soranatsu/Low-Power-MCA/firmware/STM32G474_AD7980_FinalAdaptive_ver2.6.2/DOCUMENT_ANALYSIS.md

# 文档结论与工程落实矩阵

| 资料 | 与本工程有关的结论 | 工程落实 |
|---|---|---|
| 赛题讲解、基础信息 | 需要外部输入0–1 V能谱、至少1024道；覆盖500 mV/1 kHz、100–900 mV每50 mV、100 mV/1–100 kHz测试 | 原理图BAMP约2倍增益，故把ADC端0–2 V映射为4096道，等价于外部输入0–1 V；提供baseline/amplitude/frequency profile、CSV/TXT、直方图和计数统计 |
| STM32G474VET6 开发板原理图/数据手册 | PA0/1/4/5/6 可用于本板关键链；PA11/PA12 为原生 USB；LCD/FPC 与 PA0/1/5/6 等网络复用 | USB CDC 使用 PA11/PA12；LCD/FPC 完全禁用；关键引脚和危险接地脚均在 `.ioc` 中锁定 |
| AD7980 ARM/BRM 数据手册 | 三线 CS busy 模式要求 SDI 接 VIO；CNV 高启动转换且必须在完成前回低；busy 为 SDO 下降；前 16 个 SCK 下降沿给出 D15..D0；可用第 17 个下降沿释放 SDO 高阻 | CNV 不由 MCU 驱动；PA0 只收 busy；PA5 产生 16 个取数边沿和 1 个释放边沿；PA6 只输入；ARM/BRM 共用同一固件 |
| SN74LVC1G123 | `/CLR=1、A=0` 时 B 上升沿触发；`/CLR=1、B=1` 时 A 下降沿触发 | 第一片由比较器上升沿产生约 500 ns 延时窗；其 Q 下降沿触发第二片产生约 140 ns CNV |
| LTC6993-3 | `-3` 为下降沿触发且不可重触发；DIV 高时为低有效输出；脉宽由 RSET 决定 | CNV 下降沿产生约 2.54 us 的低电平 `Trig_SHDN`，固件不介入该关断窗 |
| ADG721 | 数字输入高使对应开关导通，3.3 V 逻辑兼容；开关时间远短于 1 us | PA1 在 ADC 数据及 SDO 释放完成后输出 1 us 高脉冲，使接地开关导通并放掉峰保持电容 |
| LMV7239-Q1 | 高速比较器输出建立触发边沿 | 比较器完全属于模拟触发链；MCU 只接收最终 ADC busy，不采比较器输出 |
| ADR431 | 2.5 V 精密参考，输出需按手册去耦和稳定性要求布局 | 固件用 2500 mV 作为 AD7980 满量程换算基准；实际标定可根据实测参考值调整常量 |
| ADA4841、OPA320、OPA615、OPA810、THS4631 | 属于缓冲、峰保持或备选高速模拟器件；带宽、压摆率、输入范围和稳定性影响模拟误差，但没有 MCU 配置接口 | 固件不对这些器件作控制；上板验收应以 PH_out 稳定时间、过冲、保持下垂和噪声实测为准 |
| LM66100 | USB/板上 5 V 电源路径的理想二极管、防倒灌器件 | 无软件接口；上电前必须确认器件焊接及供电方向，USB 仅承担 CDC 通信 |

## 关键计算

- AD7980 参考为 2.5 V：`voltage_mV = raw * 2500 / 65535`。
- 外部0–1 V经约2倍BAMP后对应ADC端0–2 V；2 V对应约52428码。0..52427映射到0..4095道，达到或超过52428的事件计入 `range_overflows` 并钳位到第4095道。
- 比较器阈值分压：`Vthreshold = VDAC / 10.1`；命令 `threshold 75` 会令 PA4 约输出 757.5 mV。
- 150 MHz Cortex-M4 单周期约 6.67 ns。Release 反汇编确认每次 PA5 翻转后仍保留四个 NOP；满足 AD7980 在 VIO=3.3 V 下的 tDSDO(max)=11 ns、tDIS(max)=20 ns 和 SCK 高/低时间要求。

## 边界说明

工程已通过配置加载、源码编译、链接和反汇编时序检查。数据手册分析可以证明数字接口方案一致，但不能替代实板对模拟稳定性、噪声、供电完整性和连接器镜像方向的测量；首次上电必须执行 `TEST_PROCEDURE.md` 的限流和示波器检查。
