soranatsu/Low-Power-MCA/firmware/STM32G474_AD7980_FinalAdaptive_ver2.6.2/PC_Monitor/核电子学多道分析系统_完整项目文档.docx

基于 FPGA 指数脉冲信号发生器与 STM32G474 + AD7980 的核电子学多道分析系统

从可控激励、模拟峰保持到多道能谱与 USB 上位机的端到端项目文档

完整工程档案 · 可运行验证版 · 2026年8月

文档状态：基于当前工作区、工程说明、设计文件和实板测试反馈整理。代表性数据按测试条件标注，不将单次截图结果等同于系统的普遍极限。

# 摘要与项目状态

本项目面向核电子学赛道的多道能谱测量需求，搭建了一条可重复激励、可观测时序、可配置阈值、可连续采集的端到端链路。前端使用 A7-LITE/ADA-107 上的 FPGA 产生可调双指数脉冲，模拟板完成缓冲、峰保持、触发及 AD7980 采样，STM32G474 负责 busy 事件响应和 16 位串行读数，PC 端通过 USB CDC 完成能谱显示、统计、校准、导出和状态监视。

当前工程的主线版本为 STM32G474_AD7980_FinalAdaptive。4096 道模式用于高计数率稳定运行；8192、16384 和 65536 道模式保留原始码的诊断和校准价值。ARM 与 BRM 两种 AD7980 器件采用同一数字接口和同一软件协议。

项目项 | 当前状态 | 工程含义
安全引脚约束 | 已固化 | PA2/PA3/PC4/PC5/PF2 模拟高阻；LCD/FPC/USART2 不启用
核心采集链路 | 已实板验证 | PA0/PA1/PA4/PA5/PA6 + 外部 CNV
持续能谱 | 已实板验证 | USB CDC、批量数据、CRC/序号、恢复统计
低幅平台问题 | 已通过硬件改版改善 | 保持电容由 200 pF 改为 1 nF 后低幅线性明显改善
高计数率策略 | 已定义 | 高计数率优先本地直方图；原始 16 位流用于校准/诊断
性能边界 | 仍需条件化描述 | 受模拟噪声、FPGA 激励、USB 调度和测试配置影响

# 1 项目起因与指标

项目起因为核电子学赛道对脉冲幅度测量、能谱显示和分辨率评价的综合要求。单独验证 ADC 读数不足以证明系统可用，还必须把输入端阻抗、峰保持建立、触发延迟、转换完成判定、数据传输和上位机统计放在同一条可复现实验链中。

需求维度 | 目标/约束 | 验证口径
输入激励 | 500 mV / 1 kHz；100–900 mV、50 mV 步进；100 mV / 1–100 kHz | 以板端实际幅度和频率为准，不只看发生器设定值
采样器件 | AD7980 ARM/BRM，2.5 V 参考，16 位串行输出 | ARM/BRM 的数字时序和软件接口相同
多道输出 | 至少 1024 道；工程保留 4096/8192/16384/65536 选项 | 高道址模式不等于 ADC 有效位数提升
分辨率 | 比赛目标为 FWHM < 1% 的代表性工况 | 必须注明输入幅度、匹配方式、频率和统计时间
通信 | USB CDC 实时输出、TXT/CSV 记录 | 采用安全命令白名单，不控制 CNV 和危险 GPIO

工程边界：FPGA 的 10 位 DAC 负责产生激励，AD7980 的 16 位输出负责采样量化。两者位数不同是系统分辨率链的一部分，但不能把 16 位码流直接解释为 16 位 ENOB。

# 2 总体架构

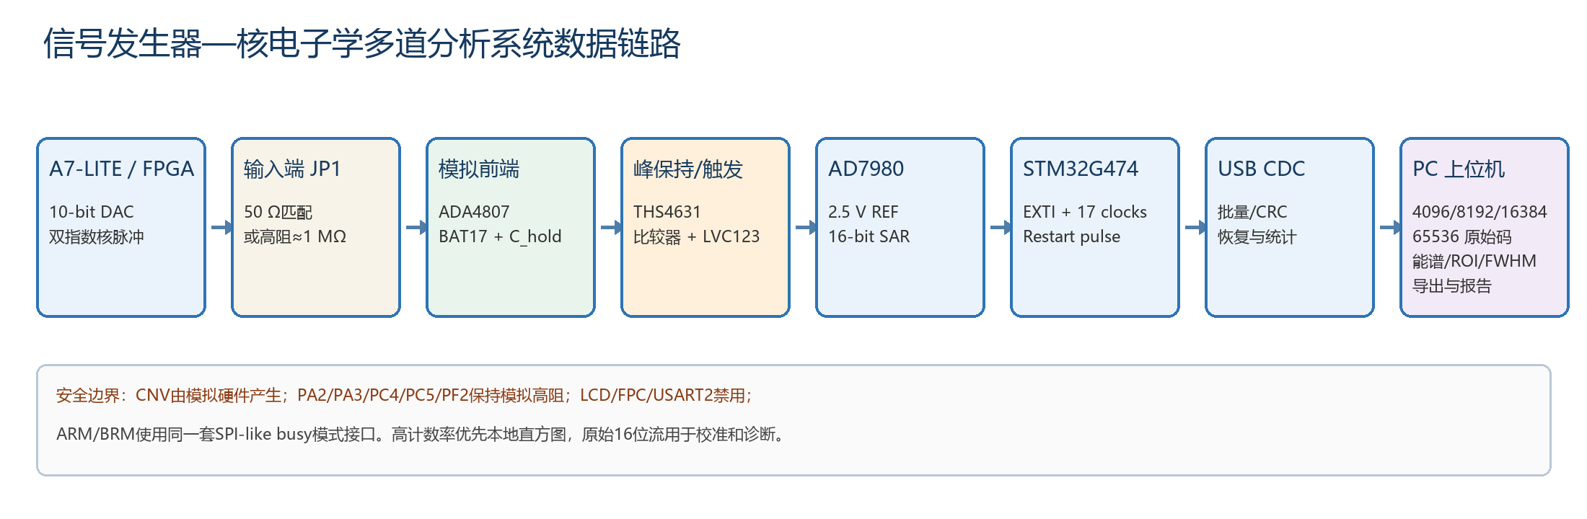
[picture p14: figure]

系统以外部模拟 CNV 为边界：CNV 由模拟板上的比较器、SN74LVC1G123 和 LTC6993-3 产生，STM32 不产生 CNV，也不主动驱动 CNV 线。MCU 只在 AD7980 转换完成后读取 SDO，并在读数结束后输出 PH_RESTART 释放峰保持电容。

层级 | 模块 | 职责
激励层 | A7-LITE + ADA-107 + FPGA | 生成可调双指数脉冲，提供可控幅度/频率和 JTAG 调试入口
模拟层 | 输入匹配、ADA4807、BAT17、THS4631 | 缓冲、峰值捕获、保持和 ADC 驱动
时序层 | 比较器、LVC123、LTC6993-3、ADG721 | 触发、延时、CNV、ADA4807 关断和保持电荷释放
采集层 | AD7980 + STM32G474 | busy 事件、16 位数据、异常统计、USB CDC
分析层 | PC_Monitor | 直方图、ROI、峰值/FWHM、cps、校准和导出

# 3 FPGA 信号发生器

当前采用 A7EXP 工程作为可调激励主线。设计使用 50 MHz 板载时钟，经 MMCM 生成 125 MHz 采样时钟；脉冲形状采用双指数模型，DAC 数据在下降沿更新，使用 ODDR 转发 DAC 时钟。该结构把数字数据更新和 DAC 采样边沿分开，便于示波器观察和后续时序约束。

功能 | 实现 | 测试/使用说明
默认点 | 500 mV、1 kHz | 用于上电后的快速基线检查
幅度调节 | 100–900 mV，步进 50 mV | K2/K3 增减，LED2 表示幅度模式
频率调节 | 1–100 kHz，步进 1 kHz | K2/K3 增减，LED1 表示频率模式
模式键 | K1 切换幅度/频率 | 按键消抖在 RTL 中实现
接口 | ADA-107 DAC 与 A7-LITE GPIO 约束 | 先空载示波器确认，再接模拟板

工程入口：C:\Users\sora\Documents\Codex\A7EXP\project\A7EXP_JTAG.xpr
实现产物：C:\Users\sora\Documents\Codex\A7EXP\project\A7EXP_JTAG.runs\impl_1\adjustable_signal_gen_top.bit
约束文件：constraints\a7lite_ada107_adjustable.xdc

测量纪律：发生器的显示值不是板端实际值。JP1 OPEN 时近似高阻，JP1 SHORT 时为 50 Ω 端接，必须在相同端接条件下用示波器测量板端输入并记录。

# 4 模拟前端与峰保持

模拟链路为 ADA4807 缓冲 → BAT17/BAT1704 峰值检测 → 保持电容 → THS4631 电压跟随 → AD7980。峰保持节点需要在触发到来后快速充电，在 ADC 采样窗口内保持，在读数后可靠复位。ADG721 将保持节点与 AGND 接通实现释放，D2 作为反馈钳位路径的一部分。

模块 | 功能 | 主要工程关注点
ADA4807 | 输入缓冲/峰值驱动 | 供电、稳定性、关断恢复瞬态、输出电流
D1 BAT17 | 单向峰值充电路径 | 方向、正向压降、反向恢复和电荷注入
C_hold | 保持峰值 | 最终实板改为 1 nF；需在带宽、建立时间和复位时间间权衡
THS4631 | 高阻跟随和 ADC 驱动 | 输入偏置、反馈布局、采样瞬态隔离
ADG721 + Restart | 释放保持电荷 | 极性和脉冲时序需与硬件原理图一致

低幅异常的定位过程是本项目最重要的迭代之一。早期 200 pF 版本在约 121 mV 以下出现约 260 mV 固定平台，示波器显示复位后节点仍有二次上升。仅延长 LTC6993-3 的 SHDN 并不能彻底消除现象；将保持电容改为 1 nF 后，用户在最低输入处重新获得了良好线性和小于 1% 的代表性分辨率。该结果说明原问题与保持节点的电荷/恢复动态强相关，但不能据此把单一器件参数当成所有板卡的普适最优值。

# 5 触发与采样时序

BUFout 分为峰保持支路和比较器支路。比较器上升沿触发第一个 SN74LVC1G123，形成约 600 ns 延时；其下降沿触发第二个单稳态，产生约 140 ns CNV 脉冲。CNV 上升沿启动 AD7980 转换，CNV 下降沿触发 LTC6993-3 使 ADA4807 进入约 6–7 µs 的关断窗口（最终实板电阻配置约为 381 kΩ 量级，具体时间以示波器为准）。转换完成后 SDO/BUSY 拉低，STM32 进入 EXTI 服务并读取数据。

阶段 | 信号 | 动作
t0 | TRIG_RAW | 比较器识别有效输入
t1 | Q_DELAY | 第一单稳态延时，等待峰保持建立
t2 | ADC_CNV 上升 | AD7980 启动转换；CNV 由模拟硬件产生
t3 | ADC_CNV 下降 / SHDN | 第二单稳态结束，LTC6993-3 进入关断窗口
t4 | SDO/BUSY 下降 | 转换完成；MCU 发送 16 个数据时钟 + 1 个释放边沿
t5 | PH_RESTART | MCU 输出约 1 µs 高脉冲，ADG721 释放保持节点

关键安全原则：MCU 不控制 CNV，不把 PA2/PA3/PC4/PC5/PF2 配成输出，不启用 LCD/FPC 复用，不使用 USART2。这样即使数字板对应焊盘接地，也不会发生 GPIO 对地硬驱动。

# 6 STM32G474 固件

固件采用 EXTI + GPIO 时钟的轻量级读数路径。PA0 作为 ADC_BUSY_IRQ 的下降沿输入；中断服务只记录事件并把读取任务放入固定大小队列，USB 文本输出、统计和格式化不在中断中执行。读取阶段生成 17 个时钟：前 16 个采集 D15..D0，第 17 个边沿使 AD7980 SDO 回到高阻。读取完成后再发 PH_RESTART，确保保持节点释放不会打断当前转换。

引脚 | 用途 | 配置/安全说明
PA0 | ADC_BUSY_IRQ | EXTI 下降沿输入；无输出驱动
PA1 | PH_RESTART | 推挽输出；只在读数完成后输出短脉冲
PA4 | THRESHOLD_DAC | DAC1_OUT1；命令值先按 1/10.1 分压补偿
PA5 | ADC_SCK | 推挽输出；仅在 busy 完成后产生读数时钟
PA6 | ADC_SDO | 输入；读取 D15..D0，最后一边沿释放
PA11/PA12 | USB FS DM/DP | USB CDC；不占用数字板额外接地针
PA2/PA3/PC4/PC5/PF2 | 用户板额外地针 | Analog/high-Z/no-pull；严禁 output/USART2

THRESHOLD_DAC = clamp(round(Vth_mV * (9.1k + 1.0k) / 1.0k), 0, 2500)
ADC_mV = raw16 * 2500 / 65535
4096_channel = clamp(floor(raw16 * 4096 / 52428), 0, 4095)

AD7980 ARM 与 BRM 在本项目中不需要两套驱动。两者的器件等级/温度等参数可能不同，但 SDI、SCK、SDO、CNV/REF 相关数字采样协议按同一 busy 模式处理；更换器件时应重新确认参考电压、模拟输入和实测建立时间。

# 7 USB CDC 与 PC 上位机

USB CDC 作为唯一 PC 通信通道。上位机向固件发送白名单命令，例如 status、format csv/txt、stream on/off、decimate N、threshold 50..200、profile、hist clear/hist dump、stats clear。CNV、GPIO 和危险引脚不在命令集中。固件与上位机通过批量传输、固定缓冲、序号、CRC16-CCITT、超时和恢复计数降低高计数率下的丢包风险。

图：FinalAdaptive 上位机界面（UI_PREVIEW）

上位机功能 | 作用 | 工程注意
采集模式 | 4096/8192/16384/65536 道显示/导出 | 16 位原始码可保留，显示道数可独立选择
统计 | 样本数、Busy、cps、Overrun、USB 恢复、处理效率 | 状态栏按意义刷新，避免刷屏
峰分析 | ROI、峰位、FWHM、分辨率、均值 | 低计数/窄峰时标记统计置信度不足
输入校准 | 50 Ω/高阻、发生器幅度、频率、前端增益 | 输入值必须是板端实测值；50 Ω 端接不可凭软件选择代替
输出 | 能谱 CSV/TXT、PNG、测试报告 | 文件中记录模式、道数、参考电压和测试条件

为什么需要 4096 高速模式：USB 原始 16 位流在 100 kcps 附近会受到包处理和 PC 调度约束；本地直方图只传统计结果，能显著降低带宽压力。高道址模式适合校准/诊断，不代表模拟链路获得同等 ENOB。

# 8 主要问题、定位与解决

现象 | 定位思路 | 解决/当前结论
PA2/PA3 输出可能对地短路 | 核对用户板额外地针和 FPC 复用 | 改为模拟高阻；放弃 USART2，使用 USB CDC
阈值设 50 mV 但 DAC 只有约 50 mV | 检查数字板 1 kΩ/9.1 kΩ 分压 | 固件补偿为约 505 mV DAC 输出；UI 显示目标比较器端阈值
低输入固定约 260 mV 平台 | 示波器观察 D1/D2、Restart、SHDN 和复位后二次上升 | 200 pF 改 1 nF 后实板低幅线性和分辨率改善
高频出现 Overrun/USB 停止 | 区分模拟无触发、MCU队列、USB传输和PC解析 | 固定队列、批量/CRC、状态节流、恢复计数；高率优先4096本地直方图
16 位模式某些幅度分辨率非单调 | 检查 FPGA 10 位 DAC 量化、端接、脉冲时间游走和统计量 | 不采用未经复测的分段增益；显示为代表性结果并标注条件
换 ARM/BRM 后行为差异 | 核对器件型号、参考和模拟焊接 | 软件接口不变；差异优先从模拟板/器件/焊接与实测时序排查

低幅平台的工程判断：单纯延长 SHDN 可以改善 ADA4807 恢复期间的干扰，但无法保证消除保持节点的所有电荷路径。用户最终采用 1 nF 保持电容后问题消失，说明原 200 pF 节点的电荷注入、二极管恢复、THS4631 输入/反馈和 ADG721 复位瞬态共同形成了可见平台。后续若更换电容或二极管，应重新测建立时间、峰值下垂和最大重复频率。

# 9 测试与验证结果

验证采用“电源—空载时序—低频激励—匹配切换—高频压力—长时间运行”的顺序。以下数字来自当前工程文档和用户实板截图，属于代表性工况，不是所有输入幅度和所有板卡的保证值。

工况 | 观测结果 | 解释
4096 道、低幅代表性测试 | 约 139 mV 峰，FWHM 约 2.8 ch，分辨率约 0.99% | 1 nF 改版后低幅线性恢复的代表性证据
4096 道、约 100 kcps | 实测计数率接近 100 kcps，处理效率可保持 100% 的代表性截图 | 推荐的高速稳定运行模式
65536 原始码流、约 139 mV | 峰位约 138.9 mV，FWHM 约 35.7 ch，分辨率约 0.98% | 原始 16 位码分析；通道数是显示/分析分辨率
65536 原始码流、约 904 mV | 峰位约 904 mV，FWHM 约 106.8 ch，分辨率约 0.225% | 代表性高幅工况；需同时查看丢包和 USB 恢复计数
高频 100 kHz 原始流 | 可能出现 Overrun 或 PC 端丢包 | 带宽与调度边界，不等同于模拟链路失效

# 10 工程风险与限制

- AD7980 的 16 位输出是理想码宽；系统 ENOB 还受 2.5 V 参考噪声、THS4631 驱动、保持电容、模拟地、电源和触发时间游走影响。
- FPGA 的 10 位 DAC 量化和双指数波形参数会影响低幅度峰位置、FWHM 和线性；发生器设定幅度必须用示波器在板端校准。
- 50 Ω 与高阻输入改变端接负载和板端实际幅度；软件的阻抗选项只负责换算和报告，不能替代物理跳帽状态。
- 原始 16 位流在高计数率下对 USB 和 PC 解析压力最大；若目标是持续高吞吐，使用 4096 本地直方图并保留状态统计。
- 上电首测应使用限流电源，逐级确认 +5 V、+3V3、+2.5 V_REF、±5 VA，再接信号和 USB；确认 PA2/PA3/PC4/PC5/PF2 没有被配置为输出。

# 11 可复现操作流程

1. 在 FPGA 工程中打开 A7EXP_JTAG.xpr，确认约束和目标器件，生成或使用已验证的 adjustable_signal_gen_top.bit。
2. 模拟板断开输入时，用限流电源上电，测量数字/模拟电源和 2.5 V 参考，确认没有异常发热。
3. 连接 STM32G474 开发板，确认 PA2/PA3/PC4/PC5/PF2 所在额外地针保持高阻；不要连接 LCD/FPC，不启用 USART2。
4. 先用示波器确认 BUFout、TRIG、Q_DELAY、CNV、SHDN、ADC_SDO、ADC_SCK、PH_RESTART 的相对顺序，再接入 FPGA 激励。
5. PC 上位机选择 COM 口，先执行 status；低频 1 kHz、500 mV 运行 10–30 s，确认峰位、cps、Overrun、USB 恢复均合理。
6. 切换 50 Ω/高阻时，物理跳帽和软件输入配置同步修改，并记录板端实际输入；需要时导出 TXT/CSV。
7. 高频压力测试先用 4096 道本地直方图；只有在需要原始码校准时才打开 65536/16384 模式，并观察队列和 USB 恢复计数。

# 12 工程文件与数据格式

资源 | 位置/说明
FPGA 工程 | C:\Users\sora\Documents\Codex\A7EXP\project\A7EXP_JTAG.xpr
FPGA 比特流 | C:\Users\sora\Documents\Codex\A7EXP\project\A7EXP_JTAG.runs\impl_1\adjustable_signal_gen_top.bit
STM32 CubeMX 工程 | outputs\STM32G474_AD7980_FinalAdaptive\STM32G474_AD7980_FinalAdaptive.ioc
固件源码 | outputs\STM32G474_AD7980_FinalAdaptive\Core\Src 与 Core\Inc
PC 上位机 | outputs\STM32G474_AD7980_FinalAdaptive\PC_Monitor
数据导出 | TXT：逐行记录；CSV：带字段/元数据的表格；原始 16 位批次带序号和 CRC16-CCITT

典型原始批次格式为 @B16,<seq>,<count>,<crc16>,<base64_payload>；4096 模式可以直接在 MCU 侧形成直方图并以统计/直方图命令输出。导出报告应保留道数、参考电压、输入匹配、发生器设定/实测值、频率、阈值、累计时间和 Overrun/恢复计数。

# 13 总结与后续工作

项目已经形成从激励、模拟处理、硬件时序、ADC 采样、嵌入式数据通路到 PC 分析的闭环。最关键的工程收益不是单一峰值截图，而是把危险引脚约束、外部 CNV 边界、AD7980 busy 读取、阈值分压补偿、峰保持复位和 USB 数据可靠性统一到一套可复现流程中。

后续若用于正式比赛或更高精度测量，建议以 1 nF 版本为基线，对输入幅度、频率、匹配方式、峰保持下垂、参考噪声和长时间吞吐建立正式测试矩阵；同时用已知幅度源和独立示波器测量给出系统误差预算，而不是只依赖上位机的换算结果。

结论：当前系统具备实板运行和组会展示条件；4096 道是高计数率首选，16 位原始码是校准/诊断首选。任何更换器件、保持电容、端接跳帽或 FPGA 波形参数的改动，都应按本报告的安全和验证流程重新确认。

# 附录 A 快速引脚表

信号 | STM32G474 | 方向 | 备注
ADC_BUSY_IRQ | PA0 | 输入/EXTI | AD7980 SDO/BUSY 完成指示
PH_RESTART | PA1 | 输出 | 读数完成后短脉冲释放 ADG721
THRESHOLD_DAC | PA4 | DAC 输出 | 目标比较器阈值需乘 10.1
ADC_SCK | PA5 | 输出 | 16+1 个读取时钟
ADC_SDO | PA6 | 输入 | D15..D0，最后释放
USB CDC | PA11/PA12 | USB FS | PC 通信
禁用/高阻 | PA2/PA3/PC4/PC5/PF2 | 模拟 | 用户板接地针；禁止输出

# 附录 B 固件命令示例

status
format csv
stream on
decimate 100
threshold 100
profile baseline
hist clear
hist dump
stats clear

以上命令只用于配置采集、格式和统计，不产生 CNV，不直接切换危险 GPIO。
