soranatsu/Low-Power-MCA/firmware/STM32G474_AD7980_FinalAdaptive_ver2.6.2/PC_Monitor/his/README.md

# 历史上位机版本

本目录保存已发布但不再作为默认入口的上位机程序和历史验证材料，便于回退、复查与版本对照。

- 当前正式版本位于上一级目录：`NuclearMcaMonitor_FinalAdaptive_v2.6.2.exe`。
- 上一级 `启动上位机.bat` 始终启动当前正式版本。
- 历史 EXE 未删除、未覆盖，但不建议用于正式数据记录。
- `03板100kHz数据复核.md` 仅作为系统标定来源的历史证据；正式界面采用统一的“系统标准线性校准”，不按板号特化。

归档日期：2026-08-19。
