soranatsu/Low-Power-MCA/firmware/STM32G474_AD7980_FinalAdaptive_ver2.6.2/RESOLUTION_DIAGNOSIS.md

# 60–150 mV 分辨率非单调的判别方法

相对分辨率通常随幅度增加而下降，只在“绝对噪声近似恒定、波形形状和采样相位不变、峰为单一近高斯分布”时成立。你给出的 60 mV/0.9%、90 mV/0.6%、110 mV/1.1%、150 mV/0.4% 对应的绝对 FWHM 约为 0.54、0.54、1.21、0.60 mV。110 mV 点的绝对峰宽也约翻倍，因此不是单纯由分母变大/变小造成。

优先级判断：

1. **发生器/触发链概率最高**：FPGA 10位 DAC 在特定码值可能出现码型相关误差；指数脉冲幅度、上升时间或基线方差也可能随码值变化。触发比较器的时间游走会改变峰保持达到峰值时的相位。
2. **峰形混合**：若110 mV谱有肩峰、双峰或偏斜，单一FWHM不再代表高斯噪声。最终版只对指标做轻度平滑，原始谱不会被改变。
3. **4096道掩盖效应**：4096道每道约0.610 mV，已接近这些峰的绝对FWHM；分箱后只有约1–2道宽，插值误差和聚合会使异常不明显。65536道能把细小峰形结构显露出来，所以“16位才出现”不等于16位代码制造了异常。
4. **代码映射可能性较低**：本版使用单调映射 `channel=(raw*channels)>>16`，不会在110 mV单点改变宽度；但仍要通过独立信号源验证。

验证时固定阈值、频率、ROI、采样时长和端接方式，对每个幅度至少采集相同有效计数。保存原始CSV并记录：峰位mV、FWHM mV、FWHM%、偏度/肩峰、Overrun和序号缺口。再用实验室脉冲发生器或稳定直流阶跃替代FPGA源重复110 mV点：异常随FPGA DAC码值移动，说明发生器；异常固定在ADC输入电压，才进一步排查前端非线性、干扰或ADC码域问题。
