soranatsu/Low-Power-MCA/firmware/STM32G474_AD7980_FinalAdaptive_ver2.6.2/PC_Monitor/his/UPGRADE_DECISIONS_v2.7.md

# Low-Power-MCA 上位机升级取舍（v2.7.0）

依据《Low-Power-MCA_上位机功能升级方案文档》，本次只实施不改变固件时序、不增加实时 USB 带宽、且物理定义能够闭合验证的功能。

## 本版实施

- 左侧“采集与显示”“输入/阻抗/校准”按真实内容高度排版，窗口较小时显示纵向滚动条，底部说明不再被裁切。
- 保留 v2.6.2 指标卡内部滚动，触发/Busy、USB丢行、FWHM 等长文本仍可完整查看。
- 新增完整能谱离线载入：支持本软件导出的 4096/8192/16384/65536 道 CSV/TXT。
- 对离线文件执行完整性校验：连续道址、唯一道址、非负计数、受支持道数，缺道时拒绝载入，避免补零造成错误统计。
- 离线谱可复算峰位、FWHM、分辨率、净峰面积和统计精度；CPS、通过率、处理效率明确标为不可用。
- STM32 固件、CNV/Busy/Restart 时序和 USB 协议均未修改，因此不影响现有 4096 道 100 kcps 采集路径。

## 已有能力，继续保留

- 4096/8192/16384/65536 道切换，原始计数导出及显示缩放。
- USB CDC 自动发现、去重、断线恢复和带 CRC/序号的高道数事件流。
- ROI、峰位、稳健 FWHM、分辨率、计数率、处理效率、脉冲通过率及线性测试报告。
- 原始串口记录、CSV/TXT/PNG 导出、谱图游标和局部峰吸附。

## 暂缓实施及原因

- **1024/2048 道模式**：当前固件明确支持 4096/8192/16384/65536，道数扩展若只在PC端合并不会改善采集性能，反而扩大协议状态组合。
- **能量刻度（keV）**：需要至少两个已知核素峰及可追溯标定记录；在没有标定点时显示 keV 不科学。
- **多 ROI 和峰识别**：需要明确峰重叠、背景模型、峰显著性和报告格式后实现，避免把噪声峰当作核素峰。
- **活时间/死时间**：现有 Busy 是触发/转换计数，不等于硬件门控活时间。应由固件增加同步 live/dead 计数器后再显示，不能从静态谱或USB到达时间反推。
- **漂移补偿、多谱对比、长期稳定性**：列入后续版本；应先定义参考峰锁定、温度来源、校正是否只影响显示或影响原始数据。
- **高斯拟合**：当前峰可能包含发生器码跳、触发时间游走和非高斯尾部，稳健半高宽更适合作为默认指标；拟合应作为可选分析而非替代原始谱。

## 验证标准

- 默认窗口与最小窗口下，左侧两个长页签顶部和底部内容均可见，滚动条范围正确。
- 空谱启动即显示坐标轴；道数切换后显示范围和游标状态原子复位。
- 离线完整谱正确载入；缺道、重复道、负计数和原始事件文件被拒绝。
- 实时连接时禁止载入离线谱；重新连接 USB 后自动退出离线状态。
- 自检继续覆盖协议解析、谱学计算、阻抗换算、线性拟合、同窗计数率、道址切换、USB端口去重和长指标滚动。
