soranatsu/Low-Power-MCA/firmware/STM32G474_AD7980_FinalAdaptive_ver2.6.2/PC_Monitor/his/03板100kHz数据复核.md

# 03板100 kHz线性度与通过率复核

数据源：`E:\天格\比赛\测试数据\03板100kHz线性度测试.csv`，共17个幅度点，50 Ω端接、发生器50 Ω负载显示、前端增益2.0。

## 结论

- CSV中的 `measured_Hz` 为 99899.114–99986.125 Hz。按统一定义 `measured_Hz/reference_Hz × 100%` 重算，真实通过率为 **99.8991%–99.9861%**。大多数点高于99.9%，最低点略低于99.9%，不能严谨地写成所有点均大于99.9%。
- 旧 `pass_percent` 的13.84%–99.77%离散不是硬件实际通过率，而是统计基线不同步：清谱使样本计数回零，但旧上位机的测量起始时间可能仍来自清零前，导致分子、分母不属于同一窗口。
- 新版在清谱、切换道址/测试模式及计数器回退后废弃旧基线，等待下一条固件状态作为统一起点；速率、通过率、处理效率和测试点报告均使用同一MCU uptime窗口。

## 线性拟合

以板端实际输入 `x` 和上位机测得输入 `y`（mV）做普通最小二乘：

`y = 1.004148380 × x - 1.160606 mV`

- `R² = 0.9999829765`
- 最大绝对残差约 `0.7001 mV`
- 按本次382 mV测试跨度归一化的最大非线性约 `0.1833% FS(test span)`

该拟合只对本块03板、本次50 Ω端接、100 kHz和相同硬件状态具有直接证据。新版将其作为**默认关闭、可编辑**的可选校准；不能替代更换板卡、温度或频率后的重新标定。

## 指标口径

- 实测计数率：`Δsamples / Δt_mcu`
- 脉冲通过率：`Δsamples / (f_ref × Δt_mcu) × 100%`
- 处理效率：`Δsamples / Δbusy × 100%`
- 触发接受率：`Δbusy / (f_ref × Δt_mcu) × 100%`
- 能量分辨率：`FWHM_channel / centroid_channel × 100%`
- 理想统计精度：`100% / sqrt(net_peak_area)`，仅表示泊松计数项，不含系统误差。
