soranatsu/Low-Power-MCA/PCB/Analog_ADC/Project Outputs for Analog_ADC/Analog_ADC_BOM_1620.xlsx

Line # | Name | Description | Designator | Quantity | Manufacturer 1 | Library Reference | LibRef
 | GRM155R61H105KE05D | 1uF 10% 50V 0402 X5R | C1, C3, C5, C36 | 4 | 1uF/50V | GRM155R61H105KE05D | GRM155R61H105KE05D
 | GCM188R72A104KA64D | 100nF 10% 100V X7R 0603 | C2, C4, C11, C14, C16, C28, C31, C37 | 8 | 100nF/100V | GCM188R72A104KA64D | GCM188R72A104KA64D
 | CC0603FRNPO9BN150 | 15pF ±1% 50V 0603 NP0 | C6 | 1 | 15pF | CC0603FRNPO9BN150 | CC0603FRNPO9BN150
 | GRM188Z71A106KA73D | 10uF 10% 10V X7R 0603 | C7 | 1 | 10uF/10V | GRM188Z71A106KA73D | GRM188Z71A106KA73D
 | GCM155R71H104KE02D | 100nF ±10% 50V 0402 GCM | C8, C17, C27, C32, C33, C38, C40, C41, C42 | 9 | 100nF | GCM155R71H104KE02D | GCM155R71H104KE02D
 | GCM188R71E105KA64D | 1uF 10% 25V X7R 0603 | C9, C15, C24 | 3 | 1uF/25V | GCM188R71E105KA64D | GCM188R71E105KA64D
 | GRT188C81E475KE13D | 4.7uF 10% 25V 0603 X6S | C10, C25 | 2 | 4.7uF/25V | GRT188C81E475KE13D | GRT188C81E475KE13D
 | CC0603KRX7R9BB471 | 470pF ±10% 50V 0603 X7R | C12, C30 | 2 | 470pF | CC0603KRX7R9BB471 | CC0603KRX7R9BB471
 | GCM1885C2A201FA16J | 200pF ±1% 100V 0603 | C13 | 1 | 200pF | GCM1885C2A201FA16J | GCM1885C2A201FA16J
 | GCM1885C1H103GA16D | 10nF 2% 50V 0603 C0G | C18, C22 | 2 | 10nF/50V | GCM1885C1H103GA16D | GCM1885C1H103GA16D
 | GRM32ER71H106KA12L | 10uF 50V 10% 1210 X7R | C19, C21 | 2 | 10uF 50V | GRM32ER71H106KA12L | GRM32ER71H106KA12L
 | GCM155R71H104KE02D | 100nF 10% 50V 0402 X7R | C20, C23 | 2 | 100nF/50V | GCM155R71H104KE02D | GCM155R71H104KE02D
 | CC0603KRX7R9BB272 | 2.7nF ±10% 50V 0603 X7R | C26 | 1 | 2.7nF | CC0603KRX7R9BB272 | CC0603KRX7R9BB272
 | GCM1885C2A100FA16D | 10pF ±1% 100V 0603 | C29 | 1 | 10pF，DNP | GCM1885C2A100FA16D | GCM1885C2A100FA16D
 | CC0603JRNPO9BN390 | 39pF ±5% 50V NP0 | C34 | 1 | 39pF NP0 | CC0603JRNPO9BN390 | CC0603JRNPO9BN390
 | GQM1875C2E750FB12D | 75pF ±1% 250V 0603 C0G | C35 | 1 | 75pF | GQM1875C2E750FB12D | GQM1875C2E750FB12D
 | GCM1885C1H5R0CA16D | ±0.25pF 5pF 50V 0603 | C39 | 1 | 5pF, DNP | GCM1885C1H5R0CA16D | GCM1885C1H5R0CA16D
 | BAT17 | 电压:4V 电流:30mA | D1, D2 | 2 | BAT17 | BAT17 | BAT17
 | PZ254V-11-02P | 1x2P 间距:2.54mm 方针 直插 | J1 | 1 | Header 2 | Header 2 | Header 2
 | PM2.54-2X20P-H85 | 2*20 排母 | J2 | 1 | PM2.54-2X20P-H85 | PM2.54-2X20P-H85 | PM2.54-2X20P-H85
 | RT0603BRE0750RL | 薄膜电阻 50Ω ±0.1% 100mW 0603 | R1, R5, R29 | 3 | 50Ω | RT0603BRE0750RL | RT0603BRE0750RL
 | RT0603BRD071ML | 1MΩ 0.1% 0603 100mW 薄膜 25ppm/℃ 工作电压75V | R2, R6, R13 | 3 | 1MΩ | RT0603BRD071ML | RT0603BRD071ML
 | RT0603BRE0722RL | 薄膜电阻 22Ω ±0.1% 100mW 0603 | R3, R11, R21, R24, R30 | 5 | 22Ω | RT0603BRE0722RL | RT0603BRE0722RL
 | RT0603BRB07470RL | 薄膜电阻 470Ω ±0.1% 100mW 0603 | R7, R8 | 2 | 470Ω | RT0603BRB07470RL | RT0603BRB07470RL
 | PMR03EZPJ000 | 厚膜电阻 0Ω 250mW 0603 | R9, RT4, RT16, RT31 | 4 | 0Ω | PMR03EZPJ000 | PMR03EZPJ000
 | RT0603BRD07100KL | 100kΩ 0.1% 0603 100mW 薄膜 25ppm/℃ | R10, R27 | 2 | 100kΩ | RT0603BRD07100KL | RT0603BRD07100KL
 | RT0603BRD071KL | 薄膜电阻 1kΩ ±0.1% 100mW 0603 | R12 | 1 | 1kΩ | RT0603BRD071KL | RT0603BRD071KL
 | RT0603BRE0791RL | 薄膜电阻 91Ω ±0.1% 100mW 0603 | R14 | 1 | 91Ω | RT0603BRE0791RL | RT0603BRE0791RL
 | TD03G3480BT | 薄膜电阻 348Ω ±0.1% 100mW 0603 FH | R15 | 1 | 348Ω | TD03G3480BT | TD03G3480BT
 | RT0603BRD072KL | 2kΩ 0.1% 0603 100mW 薄膜 25ppm/℃ | R17 | 1 | 2kΩ | RT0603BRD072KL | RT0603BRD072KL
 | RT0603BRD0782KL | 薄膜电阻 82kΩ ±0.1% 100mW 0603 | R18 | 1 | 82kΩ | RT0603BRD0782KL | RT0603BRD0782KL
 | RT0603BRE075KL | 薄膜电阻 5kΩ ±0.1% 100mW 0603 | R19 | 1 | 5kΩ | RT0603BRE075KL | RT0603BRE075KL
 | RT0603BRD0720RL | 薄膜电阻 20Ω ±0.1% 100mW 0603 | R20 | 1 | 20Ω | RT0603BRD0720RL | RT0603BRD0720RL
 | RT0603FRD0747KL | 薄膜电阻 47kΩ ±1% 100mW 0603 | R23, R33 | 2 | 47kΩ | RT0603FRD0747KL | RT0603FRD0747KL
 | RT0402BRD0710KL | 10kΩ 0.1% 0402 62.5mW 薄膜 25ppm/℃ | R25, R26 | 2 | 10kΩ | RT0402BRD0710KL | RT0402BRD0710KL
 | RT0603BRD07100RL | 薄膜电阻 100Ω ±0.1% 100mW | R28 | 1 | 100Ω | RT0603BRD07100RL | RT0603BRD07100RL
 | HJ-SMA508 |  | RF1 | 1 | HJ-SMA508 | HJ-SMA508 | HJ-SMA508
 | RT0603DRE07127KL | 薄膜电阻 127kΩ ±0.5% 100mW 0603 | Rset | 1 | 127kΩ | RT0603DRE07127KL | RT0603DRE07127KL
 | ADG721 |  | S1 | 1 | ADG721 | ADG72x | ADG72x
 | ADA4807-1ARJZ-R2 |  | U1, U4 | 2 | ADA4807-1ARJZ-R2 | ADA4807-1ARJZ-R2 | ADA4807-1ARJZ-R2
 | LTC6993CS6-3#TRMPBF | 下降沿触发单稳态触发器 | U2 | 1 | LTC6993-3 | LTC6993-3 | LTC6993-3
 | AD7980 | 16-Bit, 1 MSPS PulSAR ADC in MSOP/QFN | U5 | 1 | AD7980 | AD7980 | AD7980
 | THS4631DR | 高压，高 slew rate，宽带 FET 输入运算放大器 | U6 | 1 | THS4631DR | THS4631DR | THS4631DR
 | SN74LVC1G123DCTR | 单稳态多谐振荡器 | U7, U8 | 2 | SN74LVC1G123DCTR | SN74LVC1G123DCTR | SN74LVC1G123DCTR
 | LMV7239QDBVRQ1 |  | U9 | 1 | LMV7239QDBVRQ1 | LMV7239QDBVRQ1 | LMV7239QDBVRQ1
 | ADR431 |  | U_REF1 | 1 | ADR431 | ADR43x | ADR43x
 | LT1761ES5-2.5 | Low Noise LDO (100mA)-> 1.2~3.3V~5V, or Adj<20V | U_VDD1 | 1 | LT1761ES5-2.5 | LT1761-fix | LT1761-fix
