soranatsu/Low-Power-MCA/PCB/DIGITAL/Digital - 3xboard - 260804 - 1415/Project Outputs for Digital/Digital1_BOM_1727.xlsx

Line # | Name | Description | Designator | Quantity | Manufacturer 1 | LibRef | Library Reference
 | GCM188R72A104KA64D | 100nF 10% 100V X7R 0603 | C1, C2, C19 | 3 | 100nF/100V | GCM188R72A104KA64D | GCM188R72A104KA64D
 | GRM32ER71E226KE15L | 22uF ±10% 25V 1210 X7R | C3, C4, C5, C6, C16 | 5 | 22uF | GRM32ER71E226KE15L | GRM32ER71E226KE15L
 | GCM21BC71E106KE36L | 10uF 10% 25V X7S 0805 汽车级 | C7 | 1 | 10uF/25V | GCM21BC71E106KE36L | GCM21BC71E106KE36L
 | GRM1555C1H332JE01D | 3.3nF 5% 50V 0402 NP0 | C8 | 1 | 3.3nF/50V | GRM1555C1H332JE01D | GRM1555C1H332JE01D
 | GCM1885C1H103GA16D | 10nF 2% 50V 0603 C0G | C9 | 1 | 10nF/50V | GCM1885C1H103GA16D | GCM1885C1H103GA16D
 | GRM188R71H102KA01D | 1nF ±10% 50V 0603 X7R | C10 | 1 | 1nF | GRM188R71H102KA01D | GRM188R71H102KA01D
 | GRM21BZ71A226ME15L | 22uF 10% 10V X7R 0805 | C11 | 1 | 22uF/10V | GRM21BZ71A226ME15L | GRM21BZ71A226ME15L
 | GRM32ER71H106KA12L | 10uF 50V 10% 1210 X7R | C12, C21 | 2 | 10uF 50V | GRM32ER71H106KA12L | GRM32ER71H106KA12L
 | GCM21BC72A105KE36L | 1uF 10% 100V X7S 0805 | C13 | 1 | 1uF 100V | GCM21BC72A105KE36L | GCM21BC72A105KE36L
 | GCM1885C2A221FA16D | 220pF ±1% 100V 0603 C0G | C14 | 1 | 220pF | GCM1885C2A221FA16D | GCM1885C2A221FA16D
 | GCM188R71E105KA64D | 1uF 10% 25V X7R 0603 | C15, C18, C20 | 3 | 1uF/25V | GCM188R71E105KA64D | GCM188R71E105KA64D
 | GRM32ER71H475KA88L | 4.7uF ±10% 50V X7R 1210 | C17 | 1 | 4.7uF | GRM32ER71H475KA88L | GRM32ER71H475KA88L
 | MBR0520 |  | D1 | 1 | MBR0520 | DIODE | DIODE
 | SMF13A | TVS 工作电压13V 最大钳位电压21.5V 单向 | D2 | 1 | TVS/13V | SMF13A | SMF13A
 | Header_2x22_Female_P2.54 | 插孔结构:2x22P;间距:2.54mm;行距:2.54mm;圆孔/方孔:方孔;安装方式:直插;排数:双排;总孔位数:44P;额定电流:3A;额定电压:-;插孔方向:顶部;塑高:8.5mm;触头材质:黄铜;触头镀层:金;工作温度:-40℃~+105℃; | J1, J2 | 2 | Header_2x22_Female_P2.54 | Header_2x22_Female_P2.54 | Header_2x22_Female_P2.54
 | FXLB252012-2R2-M | 2.2uH ±20% 3.3A 1008 | L1 | 1 | 2.2uH | FXLB252012-2R2-M | FXLB252012-2R2-M
 | Header_2x20_male_P2.54 | 插针结构:2x20P;间距:2.54mm;行距:2.54mm;圆针/方针:方针;安装方式:直插;排数:双排;总PIN位数:40P;额定电流:3A;配合针长度:6mm;塑高:2.54mm;端接针长度:3mm;触头材质:黄铜;触头镀层:金;工作温度:-55℃~+105℃; | P1 | 1 | Header_2x20_male_P2.54 | Header_2x20_male_P2.54 | Header_2x20_male_P2.54
 | SR0603FR-7T100RL | 100Ω 1% 0603 250mW 厚膜 耐浪涌 | R1 | 1 | 100Ω | SR0603FR-7T100RL | SR0603FR-7T100RL
 | RT0603BRE0722RL | 薄膜电阻 22Ω ±0.1% 100mW 0603 | R2 | 1 | 22Ω | RT0603BRE0722RL | RT0603BRE0722RL
 | RT0603BRE071KL | 薄膜电阻 1kΩ ±0.1% 100mW 0603 | R3 | 1 | 1kΩ | RT0603BRE071KL | RT0603BRE071KL
 | RT0603BRE079K1L | 薄膜电阻 9.1kΩ ±0.1% 100mW 0603 | R4 | 1 | 9.1kΩ | RT0603BRE079K1L | RT0603BRE079K1L
 | RT0603BRD07301KL | 薄膜电阻 301kΩ ±0.1% 100mW 0603 | R5 | 1 | 301kΩ | RT0603BRD07301KL | RT0603BRD07301KL
 | RT0603BRD0711K5L | 薄膜电阻 11.5kΩ ±0.1% 100mW 0603 | R6 | 1 | 11.5kΩ | RT0603BRD0711K5L | RT0603BRD0711K5L
 | RT0603BRD07100KL | 100kΩ 0.1% 0603 100mW 薄膜 25ppm/℃ | R7 | 1 | 100kΩ | RT0603BRD07100KL | RT0603BRD07100KL
 | RT0603BRD07100KL | 100kΩ 0.1% 0603 100mW 薄膜 25ppm/℃ | R8 | 1 | 60kΩ | RT0603BRD07100KL | RT0603BRD07100KL
 | RT0402BRD0720KL | 20kΩ 0.1% 0402 62.5mW 薄膜 25ppm/℃ | R9 | 1 | 12kΩ | RT0402BRD0720KL | RT0402BRD0720KL
 | RT0603BRD0710K5L | 薄膜电阻 10.5kΩ ±0.1% 100mW 0603 | R10 | 1 | 10.5kΩ | RT0603BRD0710K5L | RT0603BRD0710K5L
 | RT0603BRD072KL | 2kΩ 0.1% 0603 100mW 薄膜 25ppm/℃ | R11 | 1 | 2kΩ | RT0603BRD072KL | RT0603BRD072KL
 | RT0603BRD0729K4L | 薄膜电阻 29.4kΩ ±0.1% 100mW 0603 | R12 | 1 | 29.4kΩ | RT0603BRD0729K4L | RT0603BRD0729K4L
 | RT0603BRD0710KL | 薄膜电阻 10kΩ ±0.1% 100mW 0603 | R13 | 1 | 10kΩ | RT0603BRD0710KL | RT0603BRD0710KL
 | PMR03EZPJ000 | 厚膜电阻 0Ω 250mW 0603 | R14 | 1 | 0Ω | PMR03EZPJ000 | PMR03EZPJ000
 | HJ-SMA508 |  | RF1 | 1 | HJ-SMA508 | HJ-SMA508 | HJ-SMA508
 | CLS62NP-100NC | 10uH ±30% SMD-4P,6.8x6.6mm | T1 | 1 | CLS62NP-100NC | CLS62NP-100NC | CLS62NP-100NC
 | lm66100dckr_c2869734 | LM66100 具有集成式 FET 的 1.5V 至 5.5V、1.5A、0.5μA IQ 理想二极管 | U1 | 1 | lm66100dckr_c2869734 | lm66100dckr_c2869734 | lm66100dckr_c2869734
 | TPS82130SILR | 内置电感的宽输入降压DCDC，工作频率2MHz | U2 | 1 | TPS82130SILR | TPS82130SILR | TPS82130SILR
 | TPS62130RGT |  | U3 | 1 | TPS62130RGT | TPS62130RGT | TPS62130RGT
 | TPS7A9001DSKR | Imported | U4 | 1 | TPS7A90 | TPS7A9001DSKR | TPS7A9001DSKR
 | LT1931AIS5 | Imported | U5 | 1 | LT1931 | LT1931AIS5 | LT1931AIS5
