soranatsu/Low-Power-MCA/firmware/STM32G474_AD7980_FinalAdaptive_ver2.6.2/PC_Monitor/BUILD_REPORT.txt

NuclearMcaMonitor FinalAdaptive v2.7.4
Build: PASS
Output: NuclearMcaMonitor_FinalAdaptive_v2.7.4.exe
Self-test: 19/19 PASS
UI preview: PASS
Empty-spectrum preview: PASS; axes visible before the first sample
Spectrum cursor preview: PASS; local peak snap, local FWHM/resolution, click lock and in-chart edge avoidance
Left acquisition page: PASS; compact two-column form, action buttons wrap without clipping, top and bottom visible by vertical scrolling
Left input/calibration page: PASS; compact two-column form restored; editors remain directly selectable and the safety warning is fully visible
Horizontal overflow: PASS; both parameter pages are constrained to the viewport and never create a horizontal scrollbar
Spectrum toolbar: PASS; dedicated 52 px row preserves complete, equal-height range/zoom button borders
Left tab switching: PASS; 18 consecutive tab changes return to a fully rendered acquisition page
Button borders: PASS; DPI-aware fixed heights preserve complete lower borders in action and utility buttons
Flicker prevention: PASS; acquisition page uses a stable single-layer table instead of a native GroupBox inside the scroll page; full child layout runs only on first display or a real width change
Metric value wrapping: PASS; trigger/Busy, USB drops and FWHM long values remain scrollable inside cards
Offline spectrum parser: PASS; complete 4096-channel CSV accepted and exact total preserved
Offline scientific validity: static spectrum recalculates peak/FWHM/resolution/statistical precision; CPS, pass rate and processing efficiency are not inferred
Channel-mode switching: PASS; 4096/8192/16384/65536 modes atomically reset view, cursor and axis state
Log/linear switching: PASS; empty bins remain valid and repeated switching does not retain invalid limits
USB discovery: PASS; case-insensitive port deduplication and numeric ordering
Safety verification: PASS
Firmware acquisition, CNV/Busy/Restart timing and USB protocol: unchanged
Upgrade rationale: see UPGRADE_DECISIONS_v2.7.md
