soranatsu/Low-Power-MCA/firmware/STM32G474_AD7980_FinalAdaptive_ver2.6.2/PC_Monitor/test_artifacts/EMPTY_PREVIEW.png

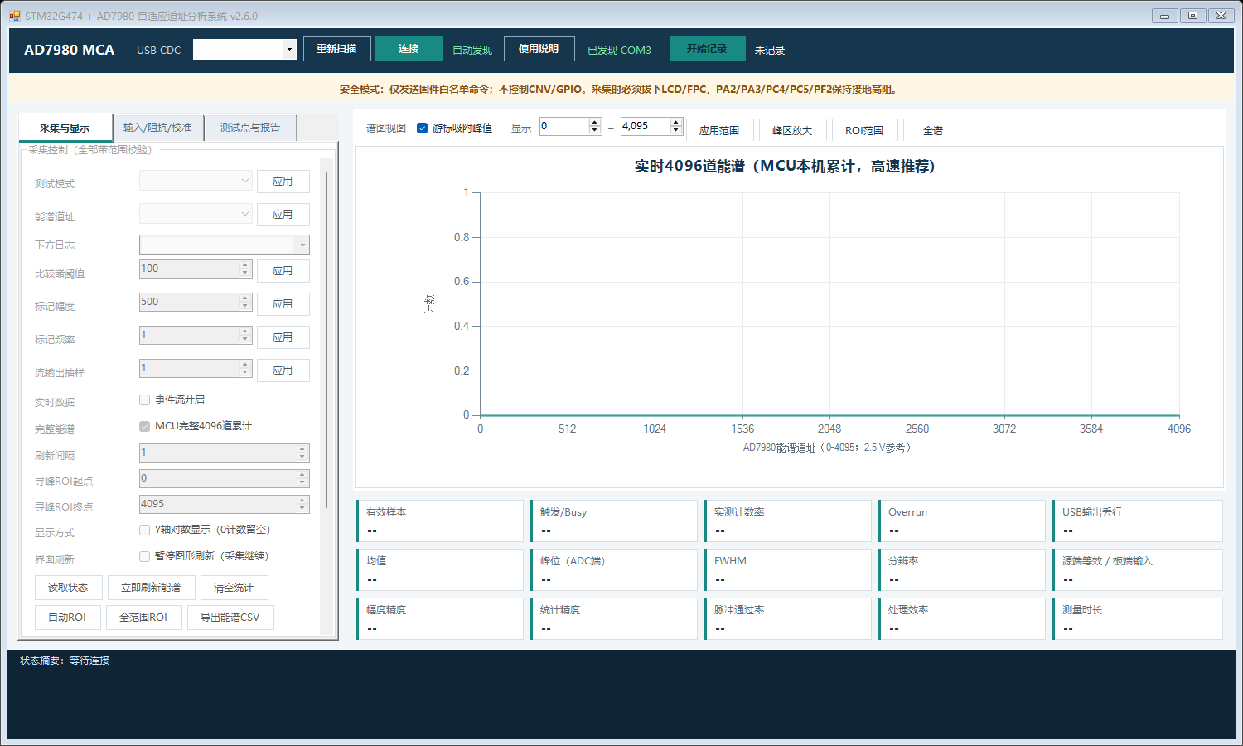
firmware/STM32G474_AD7980_FinalAdaptive_ver2.6.2/PC_Monitor/test_artifacts/EMPTY_PREVIEW.png
