soranatsu/Low-Power-MCA/firmware/STM32G474_AD7980_FinalAdaptive_ver2.6.2/PC_Monitor/test_artifacts/v2.7.0_LEFT_ACQUISITION_BOTTOM.png

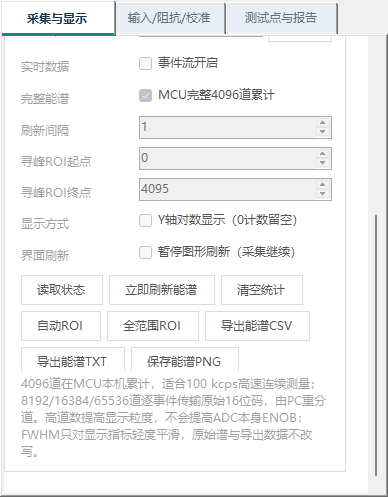
firmware/STM32G474_AD7980_FinalAdaptive_ver2.6.2/PC_Monitor/test_artifacts/v2.7.0_LEFT_ACQUISITION_BOTTOM.png
