soranatsu/Low-Power-MCA/Mannuals/开发板/原理图 & 封装/原理图 STM32G474VET6.pdf

PB12 51 PB13 52 PB14 53 PB15 54 PD8 55 PD9 56 PD10 57 PD11 58 PD12 59 PD13 60 PD14 61 PD15 62 VSS 63 VDD 64 PC6 65 PC7 66 PC8 67 PC9 68 PA8 69 PA9 70 PA10 71 PA11 72 PA12 73 VSS 74 VDD 75

STM32 | RTC供电 | USB

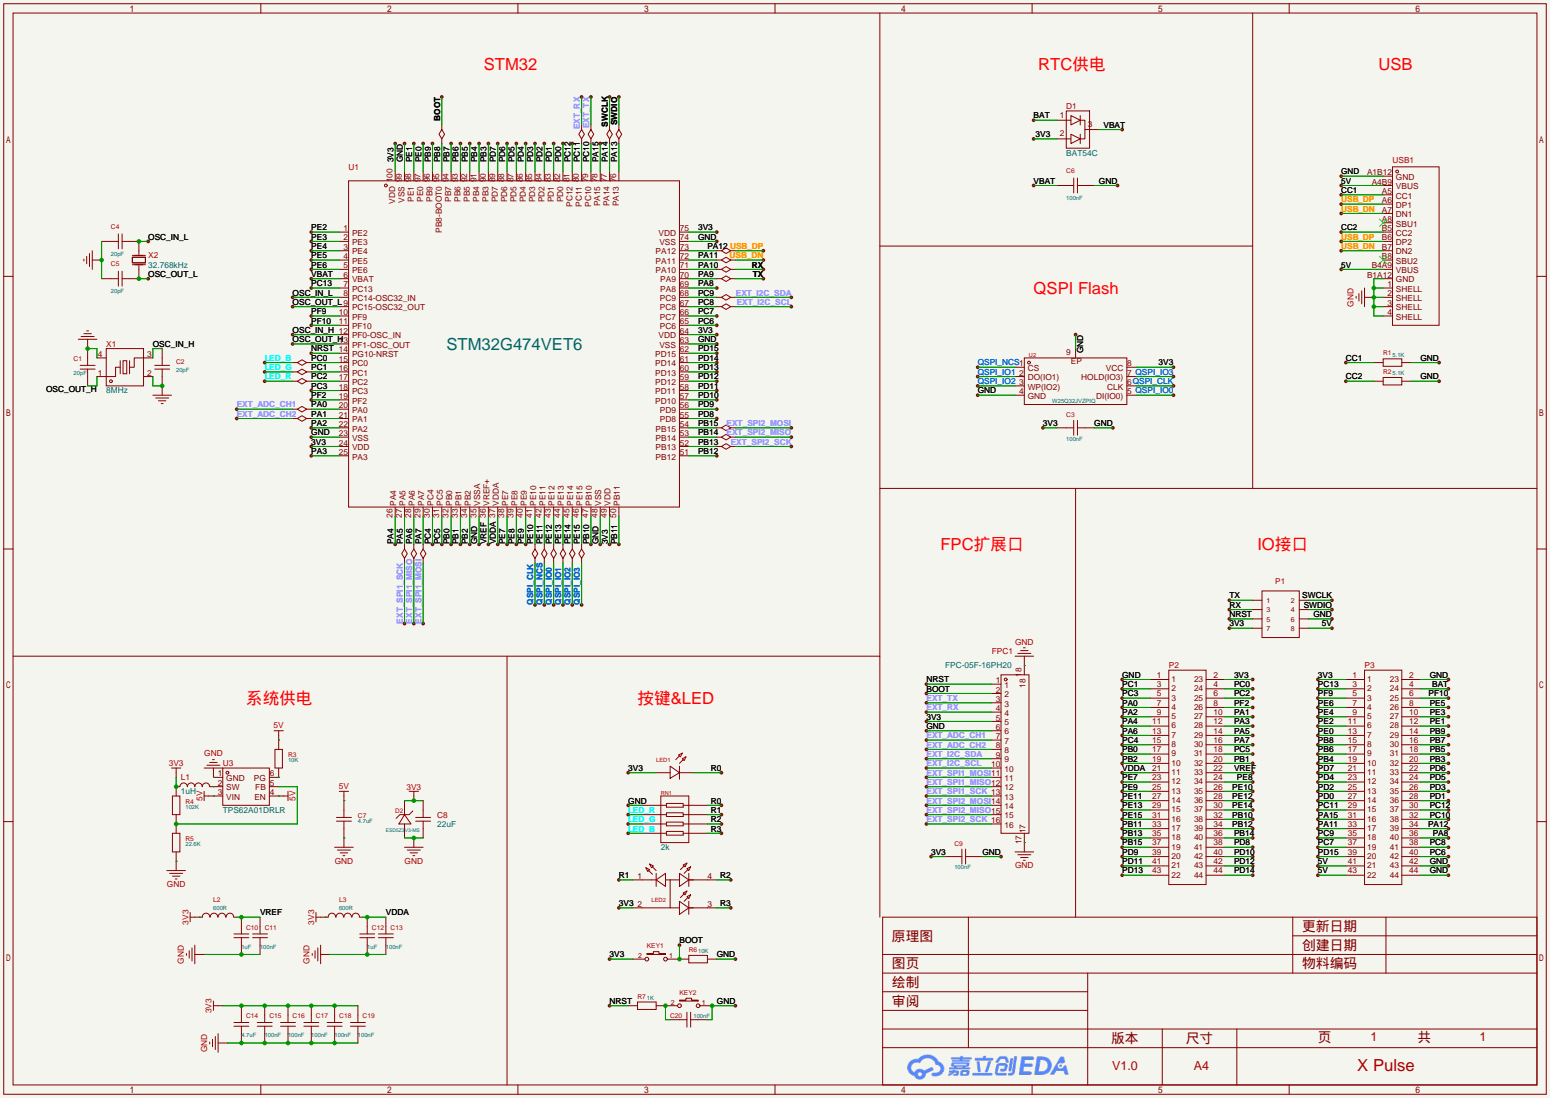
[picture p37: page 1]
