soranatsu/Low-Power-MCA/(list of files, drawings)

Other design files:
Mannuals/开发板/原理图 & 封装/STM32G474VET6 立创EDA 封装库.epro
Mannuals/开发板/原理图 & 封装/封装.pcbdoc
PCB/Analog_ADC/ADC.SchDoc
PCB/Analog_ADC/Analog.SchDoc
PCB/Analog_ADC/Analog_ADC.PcbDoc
PCB/Analog_ADC/Analog_ADC.PrjPcb
PCB/Analog_ADC/BAMP.SchDoc
PCB/Analog_ADC/Peakhold.SchDoc
PCB/Analog_ADC/Trigger.SchDoc
PCB/DIGITAL/Digital - 3xboard - 260804 - 1415/Digital.PrjPcb
PCB/DIGITAL/Digital - 3xboard - 260804 - 1415/PCB/Digital.PcbDoc
PCB/DIGITAL/Digital - 3xboard - 260804 - 1415/Schematic/Power_Digital.SchDoc
PCB/DIGITAL/Digital_with_mcu/Digital_with_mcu/Digital_with_mcu (6-8-2026 19-25-58)/Digital.PcbDoc
PCB/DIGITAL/Digital_with_mcu/Digital_with_mcu/Digital_with_mcu (6-8-2026 19-25-58)/Digital.PrjPcb
PCB/DIGITAL/Digital_with_mcu/Digital_with_mcu/Digital_with_mcu (6-8-2026 19-25-58)/Digital.SchDoc
