soranatsu/Low-Power-MCA/firmware/STM32G474_AD7980_FinalAdaptive_ver2.6.2/Core/Src/main.c

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
/* Includes ------------------------------------------------------------------*/
#include "main.h"
#include "usb_device.h"

/* USER CODE BEGIN Includes */
#include "ad7980.h"
#include "app.h"

/* USER CODE END Includes */

DAC_HandleTypeDef hdac1;

void SystemClock_Config(void);
static void MX_GPIO_Init(void);
static void MX_DAC1_Init(void);
/**
  * @brief  The application entry point.
  * @retval int
  */
int main(void)
{

  /* MCU Configuration--------------------------------------------------------*/

  /* Reset of all peripherals, Initializes the Flash interface and the Systick. */
  HAL_Init();

  /* Configure the system clock */
  SystemClock_Config();

  /* Initialize all configured peripherals */
  MX_GPIO_Init();
  MX_DAC1_Init();
  MX_USB_Device_Init();
  /* USER CODE BEGIN 2 */
  App_Init(&hdac1);
  /* Allow the 9.1k/1k + 100 nF threshold node to settle before enabling
   * the SDO/BUSY interrupt. CNV remains exclusively hardware generated. */
  HAL_Delay(2U);
  AD7980_Init();

  /* USER CODE END 2 */

  /* Infinite loop */
  /* USER CODE BEGIN WHILE */
  while (1)
  {
    App_Run();
    /* USER CODE END WHILE */

    /* USER CODE BEGIN 3 */
  }
  /* USER CODE END 3 */
}

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
/* USER CODE BEGIN 4 */
void HAL_GPIO_EXTI_Callback(uint16_t GPIO_Pin)
{
  if (GPIO_Pin == ADC_BUSY_IRQ_Pin)
  {
    AD7980_BusyISR();
  }
}

/* USER CODE END 4 */
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
