soranatsu/Low-Power-MCA/(commit log)

2026-08-19 Final Adaptive Version Released
    [ADC.SchDoc, Analog.SchDoc, Analog_ADC.PcbDoc, Analog_ADC.PrjPcb, Analog_ADC_BOM_1620.xlsx, BAMP.SchDoc, Digital.PcbDoc, Digital.PrjPcb]
2026-08-19 power consumption test
    [power_consumption_test_data.csv]
