soranatsu/Low-Power-MCA/(notices)

Notices in the files:
firmware/STM32G474_AD7980_FinalAdaptive_ver2.6.2/Core/Src/main.c:
Copyright (c) 2026 STMicroelectronics.
All rights reserved.
This software is licensed under terms that can be found in the LICENSE file
